wouter291/Lets-Move-It-Turntable-Drawings/Carrousel_MIR/Render_Carrousel_MIR4K.JPG

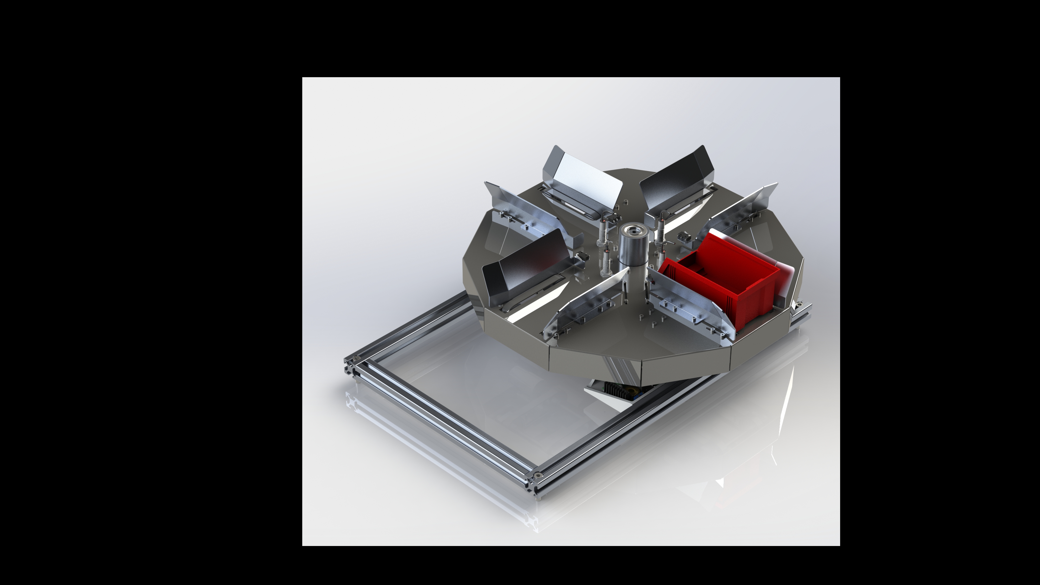
Carrousel_MIR/Render_Carrousel_MIR4K.JPG
