wouter291/Lets-Move-It-Turntable-Drawings/Carrousel_MIR/BillOfMaterials_Let's_Move_It.xlsx

Number | QTY | Functie | Model/Type | Leverancier - artikelnummer
1 | 1 | Stepper driver carousel | TB6600 | Tinytronics 001848 (https://reprapworld.nl/products/elektronica/stappenmotoraansturing/tb6600_stappenmotor_3_5a_1_32_microstappen_9_42v/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)
2 | 2 | Converter 24v to 12v carousel | XL4016 200W | Tinytronics 000938 (https://www.tinytronics.nl/shop/nl/spanning-converters/step-down/dc-dc-verstelbare-step-down-buck-converter-xl4016-200w)
3 | 1 | Neutrik 90 degree connector carousel | Neutrik NC4MRX-B | Conrad 730644 (https://www.conrad.nl/p/neutrik-nc4mrx-b-xlr-connector-stekker-haaks-aantal-polen-4-zwart-1-stuks-730644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)
4 | 4 | Microswitch/endstop carousel | Microswitch DC1C-H1LD | Conrad 704655 (https://www.conrad.nl/p/cherry-switches-microschakelaar-dc1c-h1ld-250-vac-6-a-1x-aanaan-ip67-schakelend-1-stuks-704655)
5 | 1 | Stepper motor carousel | Nema23 12,85KG.cm | Reprapworld SMNM23S18KG13 (https://reprapworld.nl/products/motoren_fans/stappenmotoren/nema23_stappenmotor_1_8_stap_12_85_kg_cm/?search/)
6 | 2 | H-bridge DC motor carousel | L298 | Tinytronics 000117 (https://www.tinytronics.nl/shop/nl/robotica/motoren/motoraansturingen/l298n-bipolaire-stappenmotor-en-dc-motor-motoraansturing)
7 | 4 | DC motor carousel | Aslong JGB37-3530 | Tinytronics 001416 (https://www.tinytronics.nl/shop/nl/robotica/motoren/motor/aslong-jgb37-3530-transmissiemotor-12v-dc-20rpm)
8 | 16 | Timing belt pulley carousel | Reely alu B:8mm,D45mm, T25 | Conrad 226025 (https://www.conrad.nl/p/reely-aluminium-tandriemschijf-boordiameter-8-mm-diameter-45-mm-aantal-tanden-25-226025)
9 | 8 | Timing belt carousel | Reely belt outside 330mm, 65 teeth | Conrad 226076 (https://www.conrad.nl/p/reely-distributieketting-buitenomvang-330-mm-aantal-tanden-65-226076)
10 | 4 | Induction sensor carousel | LJ12A34Z/BX | Tinytronics 001974 (https://www.tinytronics.nl/shop/nl/3d-printen/onderdelen/proximity-switch-lj12a34zbx-4mm)
11 | 1 | Raspberry pi cover carousel | Raspberry Pi 2-3(B) behuizing | Tinytronics 002030 (https://www.tinytronics.nl/shop/nl/raspberry-pi/behuizingen/raspberry-pi-2-3(b)-behuizing-transparant-optie-voor-ventilator-1)
12 | 1 | Raspberry pi 3B carousel | Raspberry Pi 3 model B+ | Tinytronics 001587 (https://www.tinytronics.nl/shop/nl/raspberry-pi/behuizingen/raspberry-pi-2-3(b)-behuizing-transparant-optie-voor-ventilator-1)
13 | 1 | groove ball bearing carousel | Radial bearing 6004 2rs B20mm O42mm | Conrad 198704 (https://www.conrad.nl/p/groefkogellager-radiaal-ubc-bearing-6004-2rs-boordiameter-20-mm-buitendiameter-42-mm-toerental-max-12000-omwmin-198704)
14 | 1 | tapered roller bearing carousel | bearing 32004 B20mm O42mm | Conrad 199708 (https://www.conrad.nl/p/groefkogellager-radiaal-ubc-bearing-6004-2rs-boordiameter-20-mm-buitendiameter-42-mm-toerental-max-12000-omwmin-198704)
15 | 1 | Stepper motor cable carousel | Cable for stepper motor 100cm | reprapworld 8719345004377 (https://reprapworld.nl/products/bekabeling/bekabeling/aansluitkabel_voor_stappenmotor_100cm_4_draden/?search/)
