wouter291/Lets-Move-It-Turntable-Drawings/Carrousel_MIR/3D_model/Assemblies/Frame.SLDASM

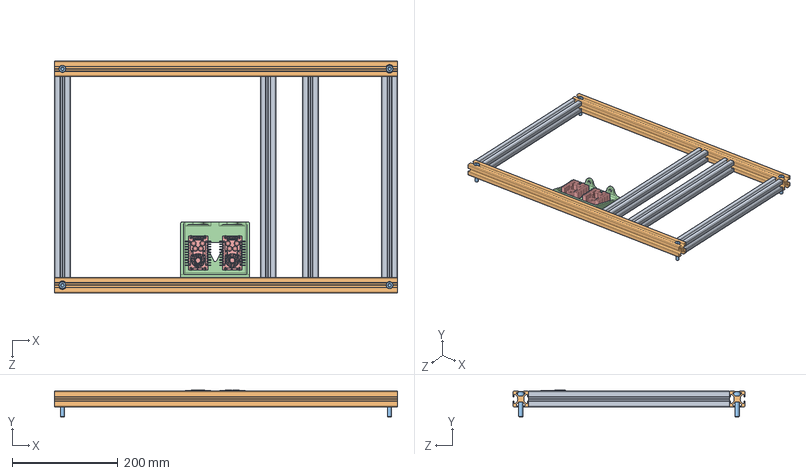
[picture p2: CAD file, 2019-06-24]
Carrousel_MIR/3D_model/Assemblies/Frame.SLDASM
650.0 x 51.0 x 440.0 mm
Frame_profile_short x 4
Frame_profile x 2
socket head cap screw_iso x 4
Converter_box
Converter x 2
