wouter291/Lets-Move-It-Turntable-Drawings/Carrousel_MIR/3D_model/Assemblies/Carrousel.SLDASM

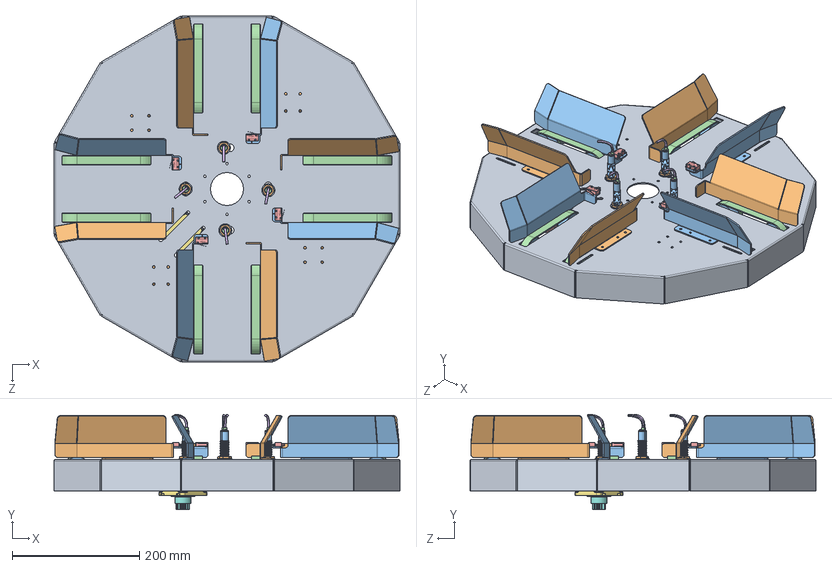
[picture p3: CAD file, 2019-06-24]
Carrousel_MIR/3D_model/Assemblies/Carrousel.SLDASM
544.0 x 149.9 x 544.0 mm
Main_disk
Side_gide x 4
Side_gide_sensor x 4
Bearing_block x 12
Engine_mount x 4
Plain_bearing x 12
Slide_axis x 4
Drive_axis x 4
Adapter_drive_axis x 4
DC_drive x 4
Timing_belt_pully x 16
Belt2-4^Carrousel x 8
Limit_switch x 4
Adjusting_ring x 12
Stepper_drive_nema23
Spur_gear_small
93925A300.step x 8
Nut.step x 8
LJ12A3-4-Z_BX.step x 4
LJ12A3-4-Z_BX-0.step x 4
LJ12A3-4-Z_BX-1.step x 4
LJ12A3-4-Z_BX-2.step x 4
