wouter291/Lets-Move-It-Turntable-Drawings/Carrousel_MIR/3D_model/Assemblies/Rotation_mechanism.SLDASM

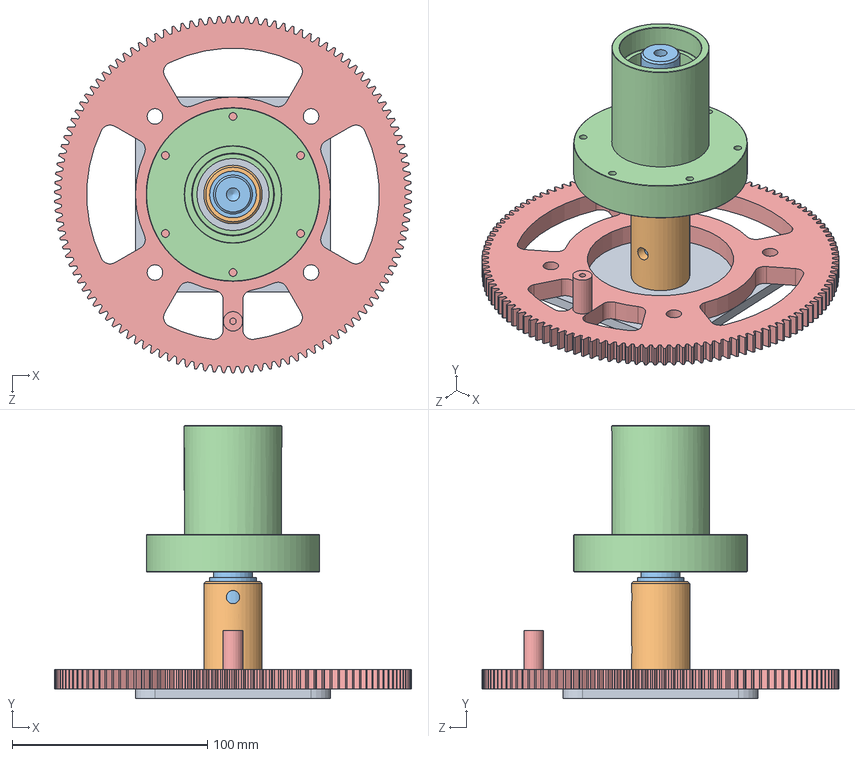
[picture p5: CAD file, 2019-06-24]
Carrousel_MIR/3D_model/Assemblies/Rotation_mechanism.SLDASM
183.0 x 140.0 x 183.0 mm
Foot
Foot_bus
Main_axis
Bearing_house_flange
Spur_gear_big
