wouter291/Lets-Move-It-Turntable-Drawings/Carrousel_MIR/3D_model/Made/Main_axis.SLDPRT

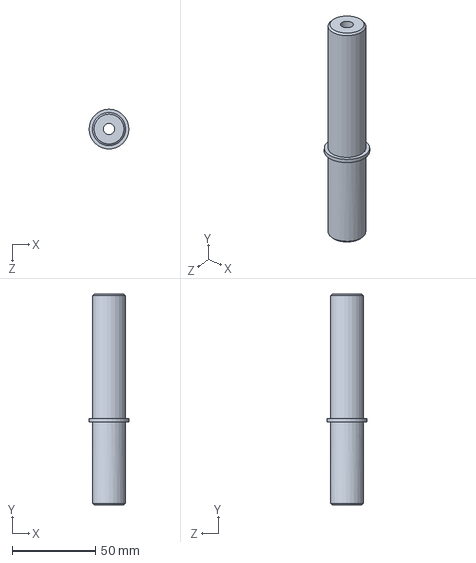
[picture p6: CAD file, 2019-06-24]
Carrousel_MIR/3D_model/Made/Main_axis.SLDPRT
24.0 x 127.0 x 23.9 mm
