wouter291/Lets-Move-It-Turntable-Drawings/Carrousel_MIR/3D_model/Made/Main_disk.SLDPRT

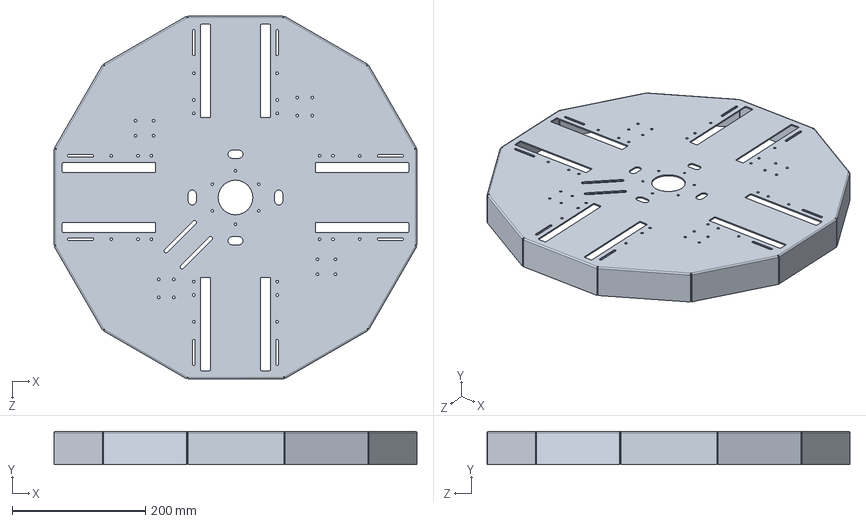
[picture p7: CAD file, 2019-06-24]
Carrousel_MIR/3D_model/Made/Main_disk.SLDPRT
544.0 x 50.0 x 544.0 mm
