wouter291/Lets-Move-It-Turntable-Drawings/Carrousel_MIR/3D_model/Made/Drive_axis.SLDPRT

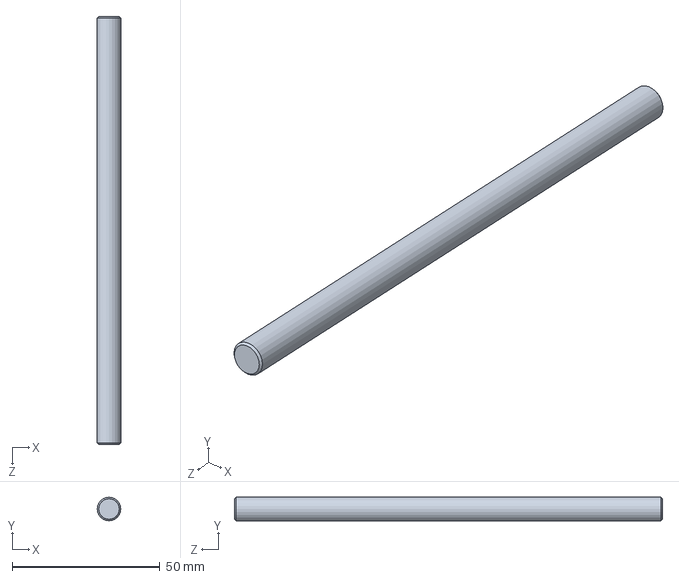
[picture p8: CAD file, 2019-06-24]
Carrousel_MIR/3D_model/Made/Drive_axis.SLDPRT
8.00 x 8.00 x 145.0 mm
