wouter291/Lets-Move-It-Turntable-Drawings/Carrousel_MIR/3D_model/Made/Side_gide_sensor.SLDPRT

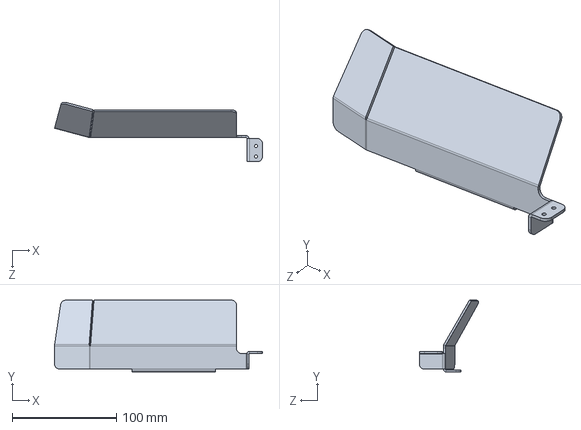
[picture p10: CAD file, 2019-06-24]
Carrousel_MIR/3D_model/Made/Side_gide_sensor.SLDPRT
199.1 x 68.8 x 56.9 mm
