wouter291/Lets-Move-It-Turntable-Drawings/Carrousel_MIR/3D_model/Made/Adapter_drive_axis.SLDPRT

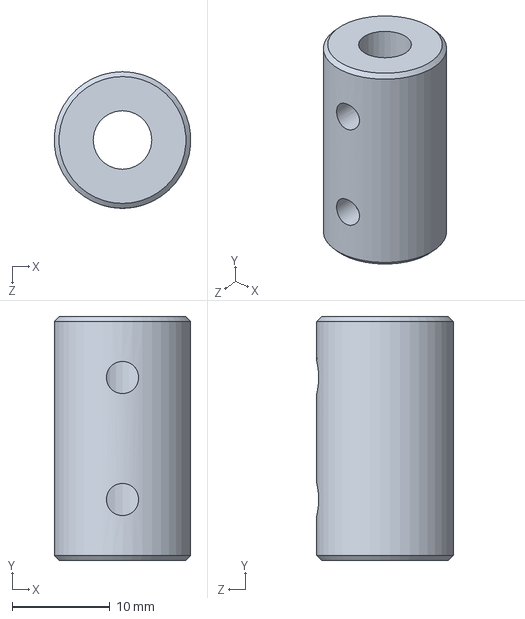
[picture p11: CAD file, 2019-06-24]
Carrousel_MIR/3D_model/Made/Adapter_drive_axis.SLDPRT
14.0 x 25.0 x 14.0 mm
