wouter291/Lets-Move-It-Turntable-Drawings/Carrousel_MIR/3D_model/Made/Laser/Side_gide_sensor.DXF

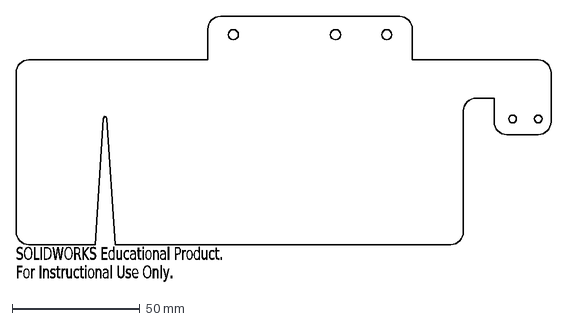
[picture p12: CAD file, 2019-06-24]
Carrousel_MIR/3D_model/Made/Laser/Side_gide_sensor.DXF
SOLIDWORKS Educational Product.
For Instructional Use Only.
