wouter291/Lets-Move-It-Turntable-Drawings/Carrousel_MIR/3D_model/Made/Side_gide.SLDPRT

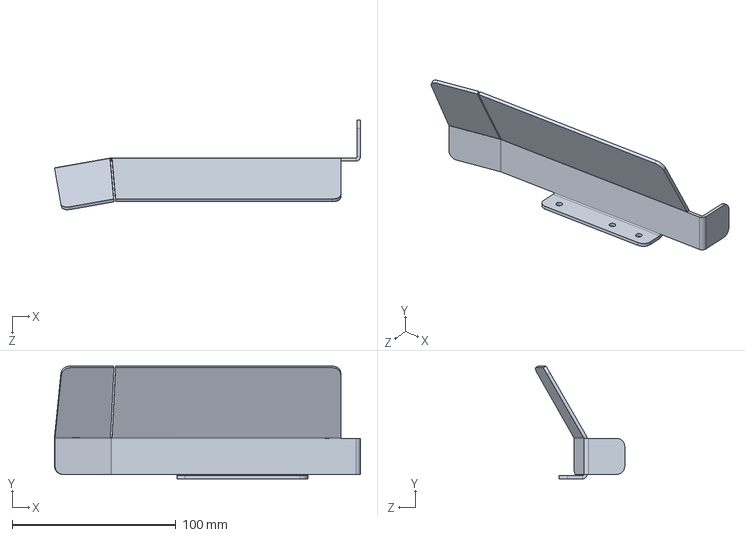
[picture p13: CAD file, 2019-06-24]
Carrousel_MIR/3D_model/Made/Side_gide.SLDPRT
186.6 x 68.8 x 54.7 mm
