wouter291/Lets-Move-It-Turntable-Drawings/Carrousel_MIR/3D_model/Made/Bearing_block.SLDPRT

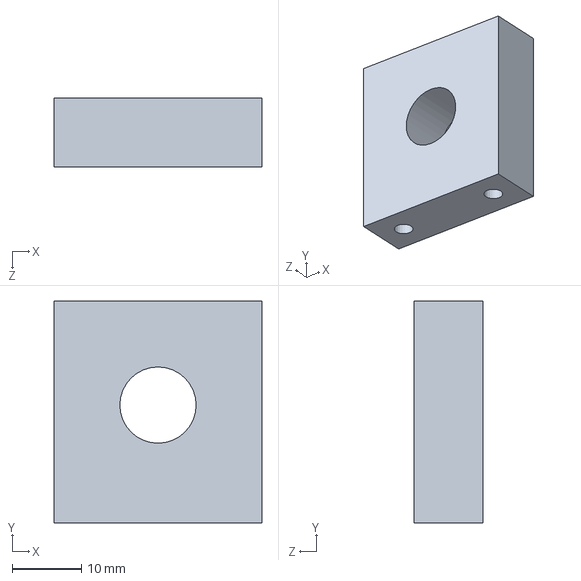
[picture p14: CAD file, 2019-06-24]
Carrousel_MIR/3D_model/Made/Bearing_block.SLDPRT
30.0 x 32.0 x 10.0 mm
