wouter291/Lets-Move-It-Turntable-Drawings/Carrousel_MIR/3D_model/Made/Foot_bus.SLDPRT

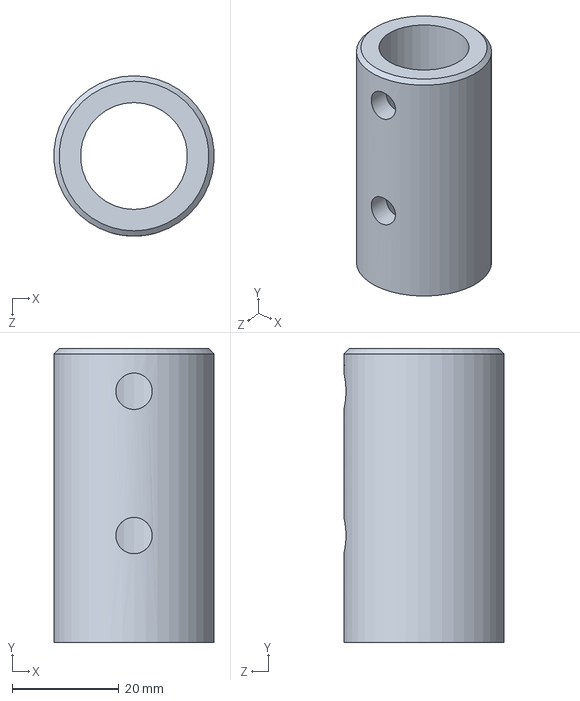
[picture p15: CAD file, 2019-06-24]
Carrousel_MIR/3D_model/Made/Foot_bus.SLDPRT
29.9 x 55.0 x 30.0 mm
