wouter291/Lets-Move-It-Turntable-Drawings/Carrousel_MIR/3D_model/Made/Bearing_house_flange.SLDPRT

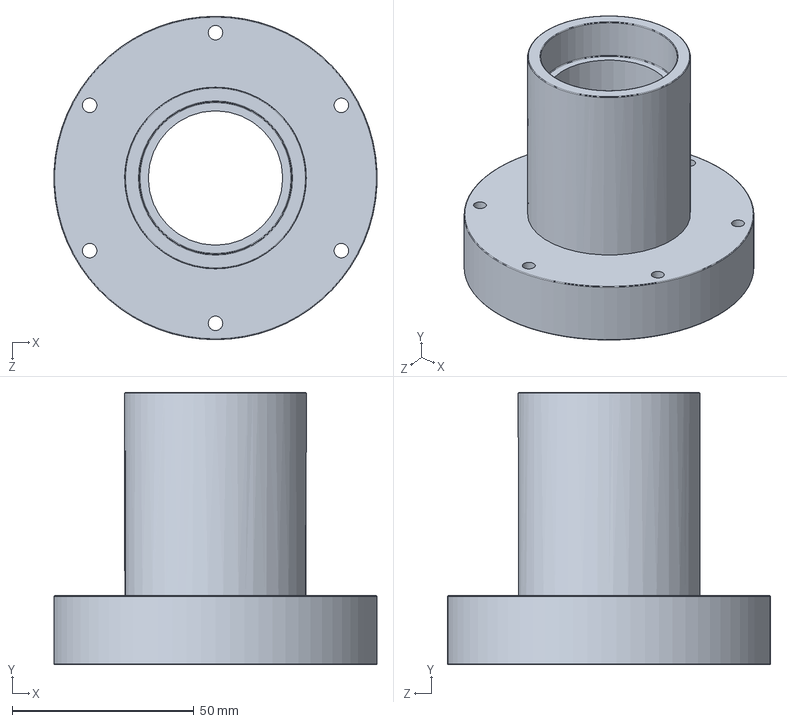
[picture p16: CAD file, 2019-06-24]
Carrousel_MIR/3D_model/Made/Bearing_house_flange.SLDPRT
88.9 x 75.0 x 89.0 mm
