wouter291/Lets-Move-It-Turntable-Drawings/Carrousel_MIR/3D_model/Made/Spur_gear_big.SLDPRT

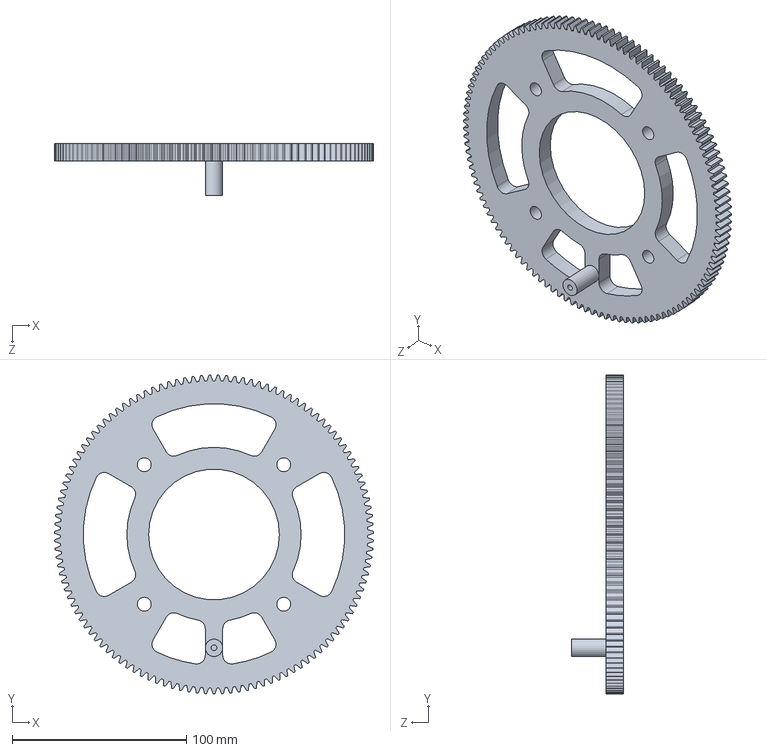
[picture p17: CAD file, 2019-06-24]
Carrousel_MIR/3D_model/Made/Spur_gear_big.SLDPRT
183.0 x 183.0 x 30.0 mm
