wouter291/Lets-Move-It-Turntable-Drawings/Carrousel_MIR/3D_model/Made/Spur_gear_small.SLDPRT

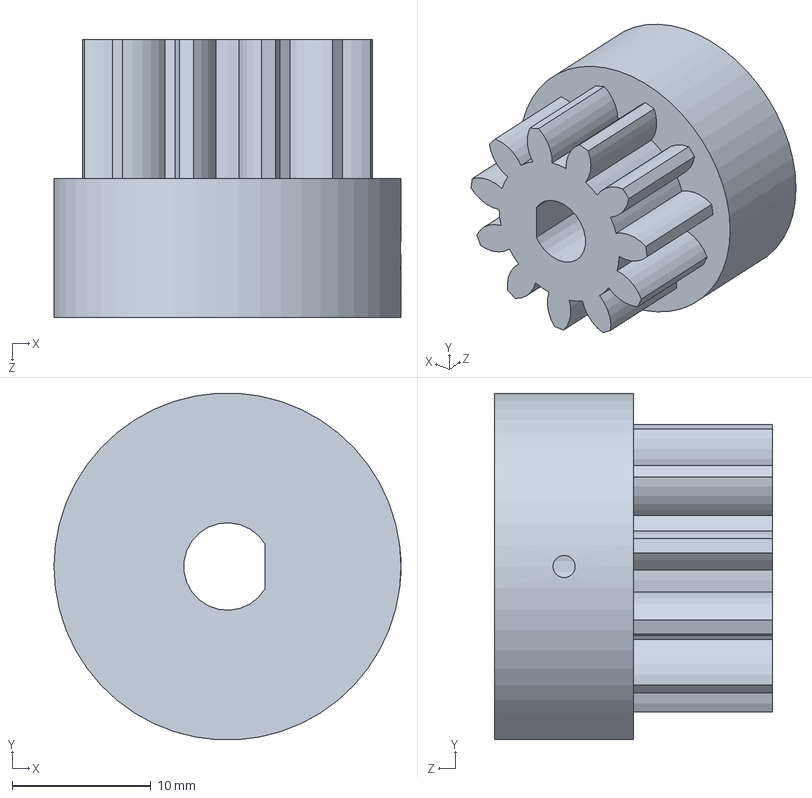
[picture p18: CAD file, 2019-06-24]
Carrousel_MIR/3D_model/Made/Spur_gear_small.SLDPRT
25.0 x 25.0 x 20.0 mm
