wouter291/Lets-Move-It-Turntable-Drawings/Carrousel_MIR/3D_model/Made/Converter_box.SLDPRT

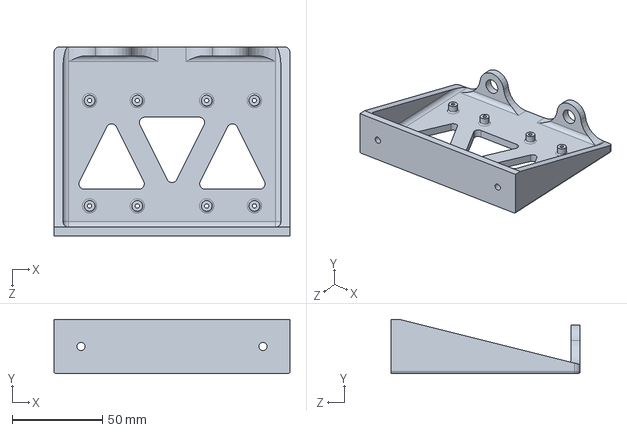
[picture p19: CAD file, 2019-06-24]
Carrousel_MIR/3D_model/Made/Converter_box.SLDPRT
131.0 x 30.0 x 105.0 mm
