wouter291/Lets-Move-It-Turntable-Drawings/Carrousel_MIR/3D_model/Made/Foot.SLDPRT

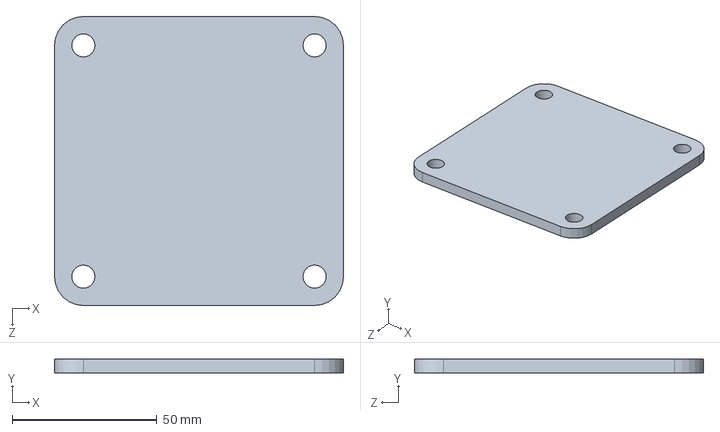
[picture p20: CAD file, 2019-06-24]
Carrousel_MIR/3D_model/Made/Foot.SLDPRT
100.0 x 5.00 x 100.0 mm
