wouter291/Lets-Move-It-Turntable-Drawings/Carrousel_MIR/3D_model/Made/Engine_mount.SLDPRT

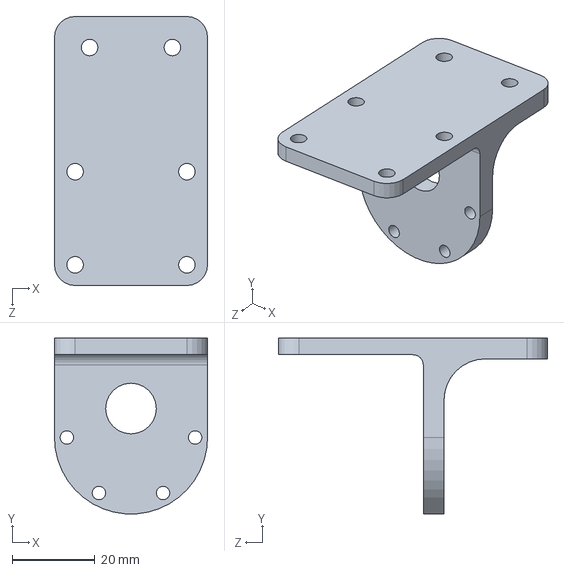
[picture p21: CAD file, 2019-06-24]
Carrousel_MIR/3D_model/Made/Engine_mount.SLDPRT
37.0 x 42.4 x 65.0 mm
