wouter291/Lets-Move-It-Turntable-Drawings/Carrousel_MIR/3D_model/Made/Slide_axis.SLDPRT

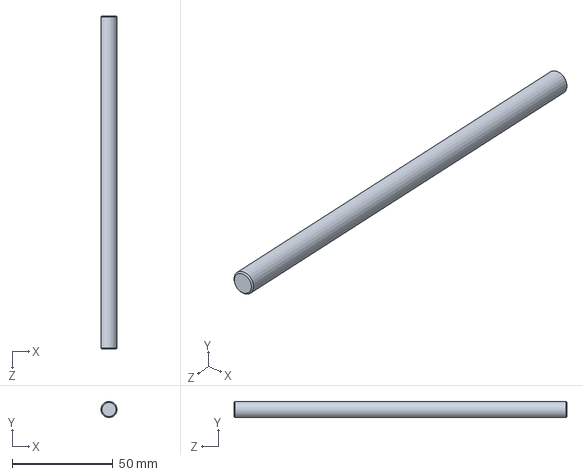
[picture p22: CAD file, 2019-06-24]
Carrousel_MIR/3D_model/Made/Slide_axis.SLDPRT
8.00 x 8.00 x 165.0 mm
