wouter291/Lets-Move-It-Turntable-Drawings/(list of files, cad)

Other CAD files:
Carrousel_MIR/3D_model/Bought/Adjusting_ring.SLDPRT
Carrousel_MIR/3D_model/Bought/Ball_bearing.SLDPRT
Carrousel_MIR/3D_model/Bought/Cone_bearing.SLDPRT
Carrousel_MIR/3D_model/Bought/Converter.SLDPRT
Carrousel_MIR/3D_model/Bought/DC_drive.SLDPRT
Carrousel_MIR/3D_model/Bought/Frame_profile.SLDPRT
Carrousel_MIR/3D_model/Bought/Frame_profile_short.SLDPRT
Carrousel_MIR/3D_model/Bought/Inductive_sensor.SLDASM
Carrousel_MIR/3D_model/Bought/Limit_switch.SLDPRT
Carrousel_MIR/3D_model/Bought/Plain_bearing.SLDPRT
Carrousel_MIR/3D_model/Bought/Stepper_drive_nema23.SLDPRT
Carrousel_MIR/3D_model/Bought/Storage_box.SLDPRT
Carrousel_MIR/3D_model/Bought/Timing_belt_pully.SLDPRT
Carrousel_MIR/3D_model/Made/3D_print/Converter_box.STL
Carrousel_MIR/3D_model/Made/3D_print/Spur_gear_big.STL
Carrousel_MIR/3D_model/Made/3D_print/Spur_gear_small.STL
Carrousel_MIR/3D_model/Made/Workshop/Adapter_drive_axis.SLDDRW
Carrousel_MIR/3D_model/Made/Workshop/Bearing_block.SLDDRW
Carrousel_MIR/3D_model/Made/Workshop/Bearing_house_flange.SLDDRW
Carrousel_MIR/3D_model/Made/Workshop/Foot.SLDDRW
Carrousel_MIR/3D_model/Made/Workshop/Foot_bus.SLDDRW
Carrousel_MIR/3D_model/Made/Workshop/Frame_profile.SLDDRW
Carrousel_MIR/3D_model/Made/Workshop/Frame_profile_short.SLDDRW
Carrousel_MIR/3D_model/Made/Workshop/Main_axis.SLDDRW
