wouter291/Lets-Move-It-Turntable-Drawings/Carrousel_MIR/Electrical_diagram.pdf

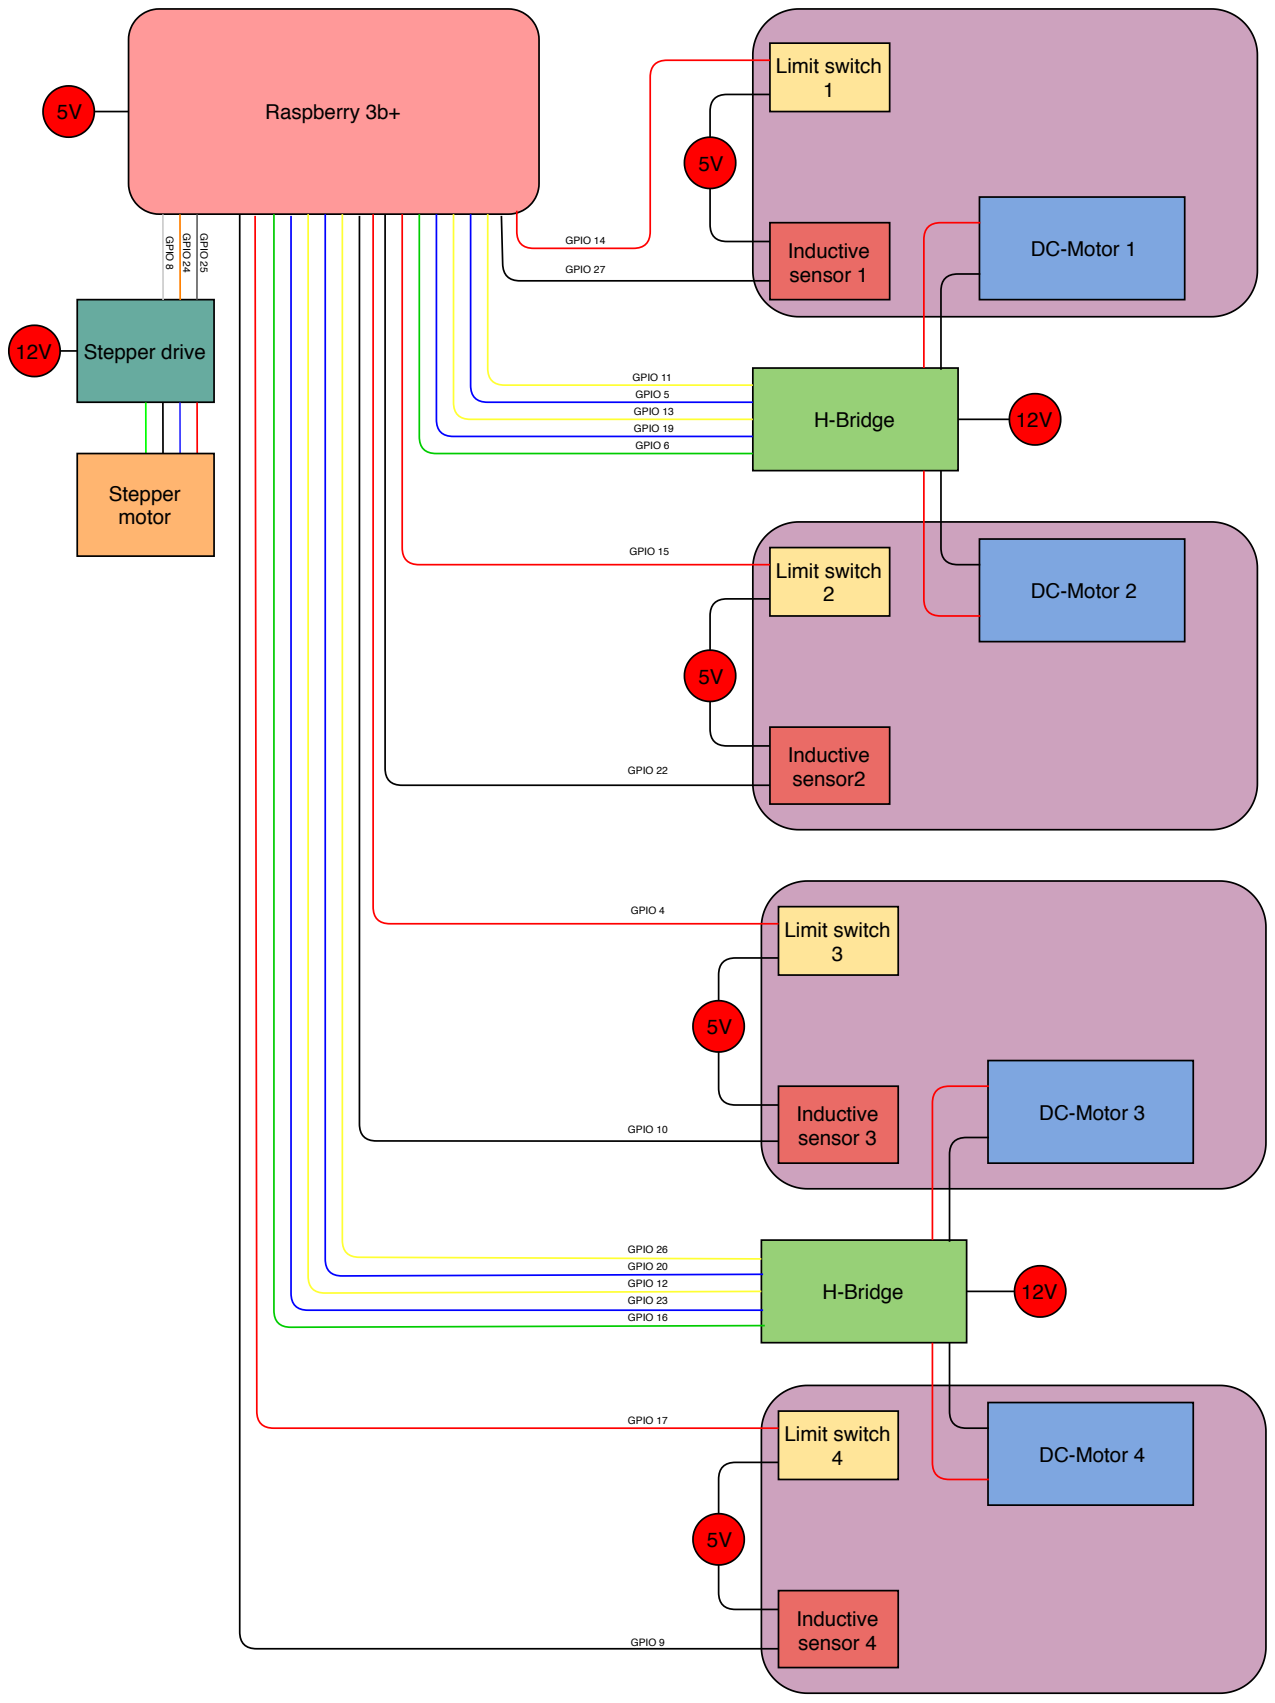
[picture p23: page 1]
Raspberry 3b+; Stepper drive; DC-Motor 1; DC-Motor 2; H-Bridge; Limit switch 1; Inductive sensor 1; Limit switch 2; Inductive sensor2; Stepper motor; DC-Motor 3; DC-Motor 4; Limit switch 3; Inductive sensor 3; Limit switch 4; Inductive sensor 4; GPIO 5; GPIO 11; GPIO 13; GPIO 19; GPIO 6; GPIO 27; GPIO 14; GPIO 15; GPIO 22; GPIO 4; GPIO 10; GPIO 26; GPIO 20; GPIO 12; GPIO 23; GPIO 16; GPIO 17; GPIO 9; GPIO 8; GPIO 24; GPIO 25
