wouter291/Lets-Move-It-Turntable-Drawings/Carrousel_MIR/3D_model/Made/Workshop/Adapter_drive_axis.PDF

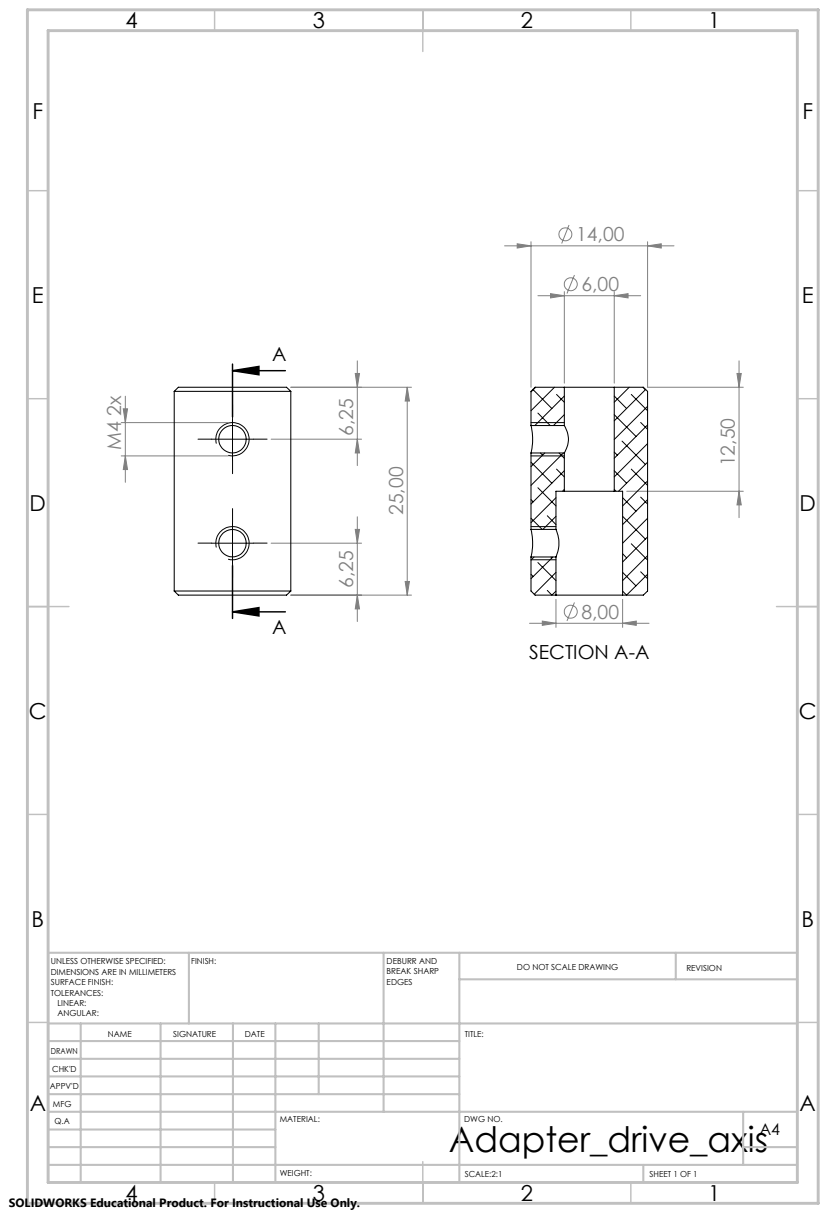
[picture p24: page 1]
SECTION A-A; FINISH:; DEBURR AND; BREAK SHARP; DO NOT SCALE DRAWING; REVISION; SCALE:2:1; SHEET 1 OF 1

UNLESS OTHERWISE SPECIFIED:
DIMENSIONS ARE IN MILLIMETERS
SURFACE FINISH:
TOLERANCES:
LINEAR:
ANGULAR:

NAME | SIGNATURE | DATE | | | | TITLE:

DRAWN
CHK'D
APPV'D
MFG
Q.A | | | | MATERIAL: Adapter_drive_axis | DWG NO. | A4

SOLIDWORKS Educational Product. For Instructional Use Only.
