wouter291/Lets-Move-It-Turntable-Drawings/Carrousel_MIR/3D_model/Made/Workshop/Bearing_house_flange.PDF

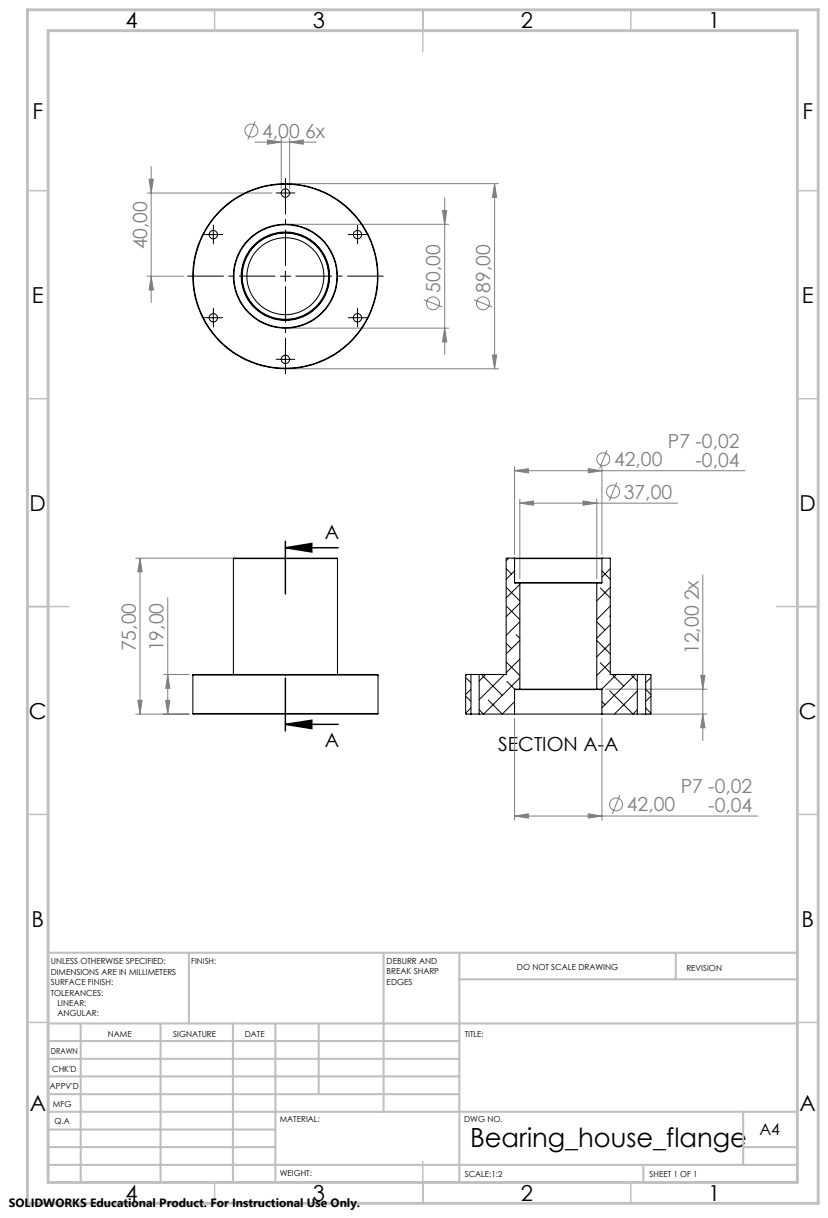
[picture p25: page 1]
SECTION A-A; FINISH:; DEBURR AND; BREAK SHARP; DO NOT SCALE DRAWING; REVISION; SCALE:1:2; SHEET 1 OF 1

UNLESS OTHERWISE SPECIFIED:
DIMENSIONS ARE IN MILLIMETERS
SURFACE FINISH:
TOLERANCES:
LINEAR:
ANGULAR:

NAME | SIGNATURE | DATE | | | | TITLE:

DRAWN
CHK'D
APPV'D
MFG
Q.A | | | | MATERIAL: | DWG NO. Bearing_house_flange | A4

SOLIDWORKS Educational Product. For Instructional Use Only.
