wouter291/Lets-Move-It-Turntable-Drawings/Carrousel_MIR/3D_model/Made/Workshop/Foot.PDF

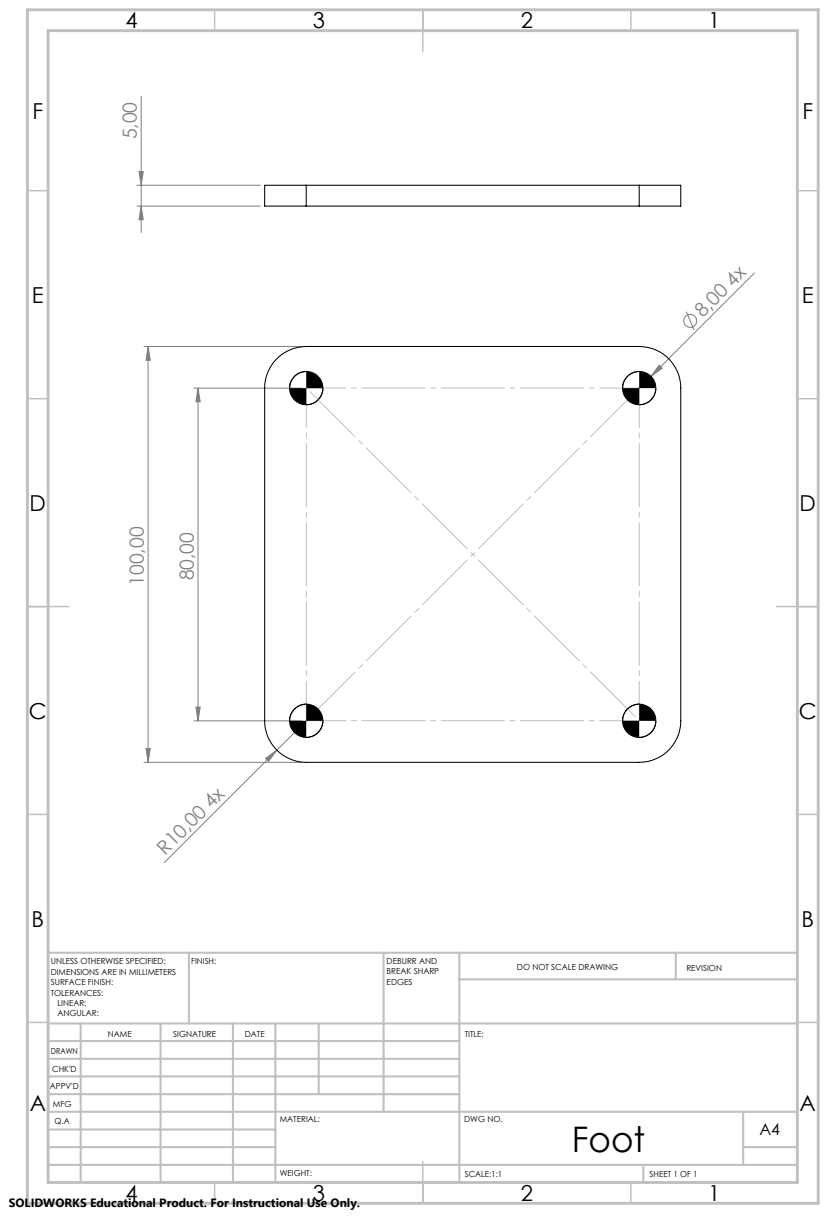
[picture p26: page 1]
FINISH:; DEBURR AND; BREAK SHARP; DO NOT SCALE DRAWING; REVISION; SCALE:1:1; SHEET 1 OF 1

UNLESS OTHERWISE SPECIFIED:
DIMENSIONS ARE IN MILLIMETERS
SURFACE FINISH:
TOLERANCES:
LINEAR:
ANGULAR:

NAME | SIGNATURE | DATE | | | | TITLE:

DRAWN
CHK'D
APPV'D
MFG
Q.A | | | | MATERIAL: | DWG NO. Foot | A4

SOLIDWORKS Educational Product. For Instructional Use Only.
